ArturVRSampaio/hatsu_ino/(list of files, cad)

Other CAD files:
boards/v0/case/case.scad
