ArturVRSampaio/hatsu_ino/(commit log)

2026-05-27 Add v1 board — startup + shutdown sound via supercapacitor hold-up
    Documents the new hardware additions (1N5819 Schottky diode, 1F supercap,
    47k/22k voltage divider on D2) and new SHUTDOWN_MODE / SHUTDOWN_TRACK
    config keys. Updates root README, docs site, and Pages workflow.
2026-05-27 Add v1 sketch — startup + shutdown sound via supercapacitor hold-up
    State machine: STATE_STARTUP plays the startup track, STATE_IDLE polls
    D2 for ignition-off, STATE_SHUTDOWN plays a track from /SHUTDOWN/ then
    sleeps. SD scanning functions refactored to accept a directory path and
    return bool so the shutdown path silently sleeps on any error instead of
    halting. Separate EEPROM addresses for shutdown sequential/shuffle/last-
    played state. logic.h extended with shutdownMode and shutdownTrack config
    fields and SHUTDOWN_MODE / SHUTDOWN_TRACK parsing.
    [hatsu_v1.ino, logic.h]
2026-05-27 Fix v1 circuit diagram to match v0 style
2026-07-17 Move SD CS to D10, extend VOLUME to 6, add ERROR_TONE config
    - SD_CS_PIN moved from D4 to D10 to free up D4
    - VOLUME range extended from 0-4 to 0-6 to support the PAM8403's
    boosted bias requirement; fixed hatsu_v0.ino to actually apply
    cfg.volume during playback instead of a hardcoded value
    - New ERROR_TONE config key (default on) beeps the speaker in sync
    with the LED error blink codes; defaults to on for errors that
    occur before CONFIG.TXT can be read (e.g. SD init failure)
    - Added tone_test sketch for standalone speaker/amp wiring checks
    - Documentation updated in README.md and CONFIG.TXT accordingly
    Claude-Session: https://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
    [CONFIG.TXT]
2026-07-18 Document RC low-pass filter, sound batch pipeline, and tone_test; fix stale AUnit include
    - README: document optional RC low-pass filter for cleaner PWM audio,
    batch-conversion pipeline for loading multiple sounds onto the SD
    card, and the tone_test hardware smoke test sketch
    - Fix test_hatsu_ino.ino's broken include (referenced a nonexistent
    "../../utils.h" left over from before logic.h moved into the sketch
    folder); symlinked logic.h into the test sketch folder since
    Arduino's build process breaks relative includes that reach outside
    the sketch directory
    Claude-Session: https://claude.ai/code/session_01DZAPxxENKW1fVCeAYfd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
    [logic.h, test_hatsu_ino.ino]
2026-07-18 Add low-pass filter resistor/capacitor to Components list
    Cross-references Step 3 so the optional R1/C1 parts are discoverable
    from the main parts list, not just the wiring section.
    Claude-Session: https://claude.ai/code/session_01DZAPxxENKW1fVCeAYfdUh9
2026-07-18 Make RC low-pass filter mandatory in circuit overview and wiring docs
    Folds R1/C1 into the main circuit diagram, Step 3 wiring, and the
    connections-at-a-glance table instead of treating them as optional
    add-ons, since the filter is needed for clean audio out of the box.
    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
2026-07-18 Fix speaker box alignment in circuit overview diagram
    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
2026-07-18 Add parametric OpenSCAD case design for v0
    Two-piece screw-together enclosure with edge-rail mounts for the
    Nano/SD module/PAM8403, a speaker grille in the lid, SD card and USB
    cutouts, and a flat back for VHB tape mounting. Dimensions are typical
    values for common breakout boards and need verifying against actual
    parts before printing.
    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
    [case.scad]
2026-07-18 Upgrade speaker spec to 1-2W 8Ω, adjust case depth to match
    The 0.5W speaker was under-matched to the PAM8403's real output
    ceiling into 8Ω (~1.5W). Bumped case interior height by 2mm for the
    deeper magnet/frame typical of a beefier speaker in the same 40mm
    footprint.
    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
    [case.scad]
2026-07-18 Fix case overlaps: microSD sizing, USB wall, Nano/speaker collision
    - SD slot resized for microSD (15mm) instead of full-size SD (26mm)
    - USB cutout was on the wrong wall entirely (Nano's connector is on
    the short edge, not the side the cutout was cut through)
    - Nano and the speaker retention ring occupied the same region —
    reworked the floor plan into two non-overlapping zones (speaker at
    X 0-46, Nano/SD/PAM stacked at X 46-92) and verified every pair of
    components by hand. in_w grew 58mm -> 80mm to fit the stack without
    cramming.
    - SD module now sits flush against the same far wall as the Nano so
    both cutouts land on one end, aligned with their connectors.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
    [case.scad]
2026-07-18 Add embossed lid logo and engraved base signature to case
    "hatsu_ino v0" embossed on the lid's outer face; "ArturVRSampaio"
    engraved into the base floor's open front strip, visible with the
    lid off. Both driven by variables (lid_label_text / sig_text) near
    the top of case.scad.
    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
    [case.scad]
2026-07-19 Cap VOLUME at 0-4, remove RC low-pass filter docs
    - VOLUME range reverted from 0-6 to 0-4: TMRpcm's volume boost above
    unity gain left-shifts each 8-bit PWM sample with no saturation,
    silently overflowing any sample that doesn't have headroom for the
    shift and producing digital noise rather than louder clean audio.
    CONFIG.TXT, logic.h, and tests all updated to match.
    - Removed the RC low-pass filter (R1/C1) from the README's circuit
    diagram, Components table, Step 3 wiring, and connections table —
    it wasn't the actual cause of the audio issues traced tonight to a
    power delivery problem (Nano powered via USB, which is current-
    limited; direct 5V/GND pin power resolved it).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
    [CONFIG.TXT]
2026-07-19 Add v1 board (DFPlayer Mini), mark v0 deprecated
    v0's Nano-driven WAV/PWM/amp chain worked but needed a lot of
    debugging to get stable (WAV header parsing, volume overflow, RC
    filtering, power delivery). v1 offloads audio entirely to a DFPlayer
    Mini module (own SD card, decoder, DAC, and amp), so the Nano just
    sends serial commands instead of doing file I/O and PWM generation.
    v1 starts minimal: play one random track on power-up, then sleep.
    No CONFIG.TXT or track-selection modes yet, and no native test suite
    since there's no board-specific pure logic to test yet. Firmware
    compiles clean but hasn't been tested on real hardware - the DFPlayer
    Mini module is still on order.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
2026-07-19 Add v1 case design; power v1 from USB (lower current draw than v0)
    - New parametric OpenSCAD case for v1 (case/case.scad), verified by
    rendering: valid manifold geometry, no overlapping components,
    wall cutouts land where expected. Dimensions are estimates pending
    the actual DFPlayer Mini module and speaker arriving.
    - Updated v1's power wiring to run off USB rather than requiring
    direct 5V/GND pin power like v0. v1's combined current draw (Nano +
    DFPlayer Mini only, no separate SD module or amp) is low enough
    that USB power should be reliable, unlike v0's higher-draw setup.
    Claude-Session: https://claude.ai/code/session_01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
    [case.scad]
2026-07-19 Make Pages build and llms.txt scan boards/ dynamically
    - pages.yml now loops over every boards/*/ folder with a README.md
    to generate docs pages, instead of hardcoding v0/v1 - new boards
    get picked up automatically.
    - docs/llms.txt is generated the same way each deploy, auto-extracting
    each board's one-line description (skipping badges/headings) rather
    than hardcoding per-board text.
    - Root llms.txt (outside the Pages build, so it can't be regenerated
    by that workflow) simplified to link generically to the boards
    folder instead of naming specific boards, so it stays accurate
    without needing a second bot-commit workflow.
    C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
2026-07-19 Add DFPlayer power-gating MOSFET to v1 firmware and docs
    Without gating the DFPlayer Mini's power, it keeps drawing its own
    idle current the whole time the Nano is asleep, undoing most of the
    point of the Nano's ~0.1uA deep sleep. D5 now drives an N-channel
    MOSFET (IRLZ44N) that cuts the DFPlayer's GND return before sleep and
    restores it at boot. Added to the circuit diagram directly (not just
    described separately) per request.
    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
2026-07-19 Add config modes, PLAY_COUNT, DELAY, and a native test suite to v1
    - CONFIG_MODE (RANDOM/SEQUENTIAL/SHUFFLE/SINGLE), CONFIG_PLAY_COUNT,
    and CONFIG_DELAY_SECONDS added as compile-time constants in
    hatsu_v1.ino, matching v0's CONFIG.TXT feature set as closely as
    possible given v1 can't read a config file off the DFPlayer's SD
    card (no filesystem access from the Nano's side).
    - New boards/v1/hatsu_v1/logic.h holds the testable pure logic for
    SEQUENTIAL/SHUFFLE index math (same approach as v0's, working on
    track numbers instead of filenames since that's all the DFPlayer
    exposes). Intentionally duplicated rather than shared with v0's
    logic.h for now, to avoid touching v0's working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
    [hatsu_v1.ino, logic.h, test_logic.cpp]
2026-07-19 Make docs home page scan boards/ dynamically too
    Same gap as before: docs/index.md hardcoded only v0 in its Boards
    table. Now generated the same way as docs/llms.txt - scans boards/*/
    at build time so new boards show up automatically.
    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
2026-07-19 Explain why the DFPlayer's 0x0A standby isn't enough, justifying the MOSFET gate
2026-07-20 Get v1 working on real hardware: fix randomAll() lockup, add query retries, tune watchdog
    - Add CONFIG_EQ and a low-voltage guard (Nano reads its own Vcc via the
    internal bandgap ref and halts before waking the DFPlayer on a sagging rail)
    - Drop reliance on the DFPlayer's randomAll() command: it never stopped
    auto-advancing on this hardware, regardless of what the Nano did
    afterward. MODE_RANDOM now reads the track count and calls play(N) on a
    Nano-picked random track instead, and MODE_SHUFFLE's overflow fallback
    does the same instead of falling back to randomAll()
    - Call disableLoopAll() defensively (some clones default to it)
    - Retry readFileCounts() up to 5 times — query-type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
    [hatsu_v1.ino, logic.h, test_logic.cpp]
2026-07-23 Add an optional shield PCB for v1 (Nano + DFPlayer + gate MOSFET)
    Generated via KiCad's pcbnew Python API (pcb/generate_board.py) rather
    than hand-drawn, from the same pin mappings already verified against
    Arduino's official Nano pinout and the DFPlayer Mini's datasheet. Female
    headers plug directly onto the Nano; sockets + a terminal block on the
    other side take the DFPlayer Mini and speaker leads; R1/R2/Q1 are routed
    into the board itself.
    DRC-clean (0 errors, 0 unconnected pads) per pcbnew.WriteDRCReport() —
    this KiCad build's kicad-cli has no `pcb drc` subcommand. Routing was
    validated with a standalone segment-intersection/clearance checker
    (check_routes.py) before trusting real DRC,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
    [hatsu_v1_shield.kicad_pcb]
2026-07-23 Shrink the shield PCB to fit under 100x100mm for cheaper prototype pricing
    Tightened the board outline from 105x46mm to 99.15x46.15mm around the
    existing routed content, without moving any component or trace, so the
    already-verified DRC-clean routing didn't need re-checking. PCB Brasil's
    prototype-tier pricing caps at 100x100mm.
    [hatsu_v1_shield.kicad_pcb]
